minkyu6877/dltla/CALIBRATION_STATUS.md

# 주행 보정 상태

최종 갱신: 2026-08-25

## 현재 확정 상태

- 로봇 1과 로봇 2의 전진 방향 및 엔코더 부호 확인 완료
- 로봇 2의 MPU6050·HC-SR04·엔코더 상태 전송 확인 완료
- RPM 자동 시험 조건: 속도 `0.05 / 0.10 / 0.15`, 워밍업 3초, 측정 5초
- 로봇 2 저속 FL/RR 불균형에 정마찰 피드포워드 적용 완료
- DW1000 앵커 A1~A4 안테나 지연값 캘리브레이션 완료
- UWB 태그 위치 UDP 송신 및 Raspberry Pi 모니터 구현 완료

현재 로봇 2 보정값:

```cpp
STATIC_FF_FL = 0.0045;
STATIC_FF_FR = 0.0000;
STATIC_FF_RL = 0.0000;
STATIC_FF_RR = 0.0055;
```

펌웨어 버전:

```text
2026-08-24-r2-wheel-ff-v1
```

## 로봇 2 보정 후 RPM 결과

| 속도 명령 | 목표 RPM | FL | FR | RL | RR |
|---:|---:|---:|---:|---:|---:|
| 0.05 | 15 | 10.00 | 11.97 | 12.93 | 10.18 |
| 0.10 | 30 | 26.81 | 28.70 | 29.62 | 25.84 |
| 0.15 | 45 | 42.45 | 44.46 | 45.86 | 42.73 |

보정 전후의 메카넘 역기구학 기준 추정치는 다음과 같습니다.

| 속도 | 예상 횡이동 비율 | 바퀴 간 최대 RPM 편차 |
|---:|---:|---:|
| 0.05 | 16.0% → 10.5% | 4.34 → 2.93 |
| 0.10 | 5.6% → 5.1% | 4.31 → 3.78 |
| 0.15 | 3.2% → 2.9% | 3.78 → 3.41 |

특히 속도 0.05에서 FL/RR 차이가 0.18 RPM까지 줄었습니다. 절대 RPM은 아직 목표보다 낮지만 직진에 중요한 바퀴 간 균형은 개선되었습니다. 단일 시험의 측정 변동을 고려해 추가 피드포워드 조정은 실제 바닥 주행 결과를 확인한 뒤 진행합니다.

## UWB 앵커 보정 결과

측정 기준 거리 `3.000 m`, 검증 표본은 앵커별 100개입니다.

| 앵커 | 주소 | 안테나 지연값 | 평균 오차 | 표준편차 |
|---|---|---:|---:|---:|
| A1 | 81:00 | 16612 | 0 mm | 19 mm |
| A2 | 82:00 | 16617 | -5 mm | 18 mm |
| A3 | 83:00 | 16598 | +3 mm | 20 mm |
| A4 | 84:00 | 16608 | +6 mm | 14 mm |

모든 앵커가 평균 절대 오차 30 mm 이하, 표준편차 50 mm 이하 기준을 통과했습니다.

위치 계산에 반영한 설치값:

- 경기장: x축 `4.000 m`, y축 `3.000 m`
- 앵커와 태그 안테나 높이: `0.100 m`
- 태그 오프셋: 로봇 중심에서 앞쪽 `0.110 m`, 왼쪽 `0.025 m`

## 다음 작업

1. 4 m x 3 m 공간에 A1~A4를 설치하고 네 변과 두 대각선 실측
2. UWB 태그 위치 송신 펌웨어 업로드 및 Raspberry Pi 수신 확인
3. 5개 기준점에서 정지 위치 오차와 RMSE를 20초씩 기록
4. 태그가 장착된 로봇의 IMU yaw와 결합해 로봇 중심 좌표 보정
5. 검증된 UWB 위치 피드백을 Raspberry Pi 주행 제어에 통합

## 1 m 주행 시험 참고

1 m 시험은 자동 거리 정지가 아니므로 로봇 앞차축이 1 m 선에 도달하면 실험 GUI의 `1m 도착·종료` 버튼을 직접 눌러야 합니다. 기준선 오른쪽 오차는 양수, 왼쪽 오차는 음수로 기록합니다.
