minkyu6877/dltla/uwb_localization/tag_position_sender/secrets.example.h

#pragma once

// Copy this file to secrets.h. Do not commit secrets.h.
const char* WIFI_SSID = "YOUR_HOTSPOT_NAME";
const char* WIFI_PASSWORD = "YOUR_HOTSPOT_PASSWORD";
const char* RASPBERRY_PI_IP = "10.44.212.72";
