minkyu6877/dltla/(commit log)

2026-08-24 Calibrate Robot 2 low-speed wheel feedforward
2026-08-24 Add ROS 2 warehouse delivery simulation
    [cargo_robot.urdf, cargo_robot_1.urdf, cargo_robot_2.urdf, mecanum_drive_controller.yaml, warehouse_l_shape.sdf]
2026-08-24 Document RPM calibration status and next tests
2026-08-25 Scale warehouse map to 4 by 3 meters
    [warehouse_l_shape.sdf]
2026-08-25 Make QR camera launch optional
2026-08-25 Add guided DW1000 UWB calibration tools
2026-08-25 Use empty test layout with corrected zone roles
    [warehouse_l_shape.sdf]
2026-08-25 Scale robot model to 230mm square footprint
    [cargo_robot_1.urdf, cargo_robot_2.urdf, mecanum_drive_controller.yaml]
2026-08-25 Model 60mm wheels and full robot footprint
    [cargo_robot_1.urdf, cargo_robot_2.urdf, mecanum_drive_controller.yaml, warehouse_l_shape.sdf]
2026-08-25 Expand delivery test map to 5 by 5 meters
    [warehouse_l_shape.sdf]
2026-08-25 Place mecanum wheels along robot sides
    [cargo_robot_1.urdf, cargo_robot_2.urdf, mecanum_drive_controller.yaml]
2026-08-25 Restore 4 by 3 meter test layout
    [warehouse_l_shape.sdf]
2026-08-25 Add automatic standby homing
2026-08-25 Add standby return and robot spacing safety
    [warehouse_l_shape.sdf]
2026-08-25 Use ultrasonic gap for robot two following
2026-08-25 Swap standby and loading layout
    [warehouse_l_shape.sdf]
2026-08-25 Move loading zone closer to standby
    [warehouse_l_shape.sdf]
2026-08-25 Stabilize mecanum wheel ground contact
    [cargo_robot_1.urdf, cargo_robot_2.urdf]
2026-08-25 Correct robot two ultrasonic gap response
2026-08-25 Add low-overhead kinematic route visualization
    [warehouse_l_shape.sdf]
2026-08-25 Use deterministic kinematic Gazebo route demo
    [cargo_robot_1.urdf, cargo_robot_2.urdf]
2026-08-25 Make follower track leader spatial path
2026-08-25 Model follower sweep around leader pivots
    [warehouse_l_shape.sdf]
2026-09-09 Add calibrated cargo mission and formation controls
